fiuba-labo-de-micro-miercoles/2019-1c-trabajo-practico-inclinador-de-vaso/doc/otros/proceso_1.jpeg

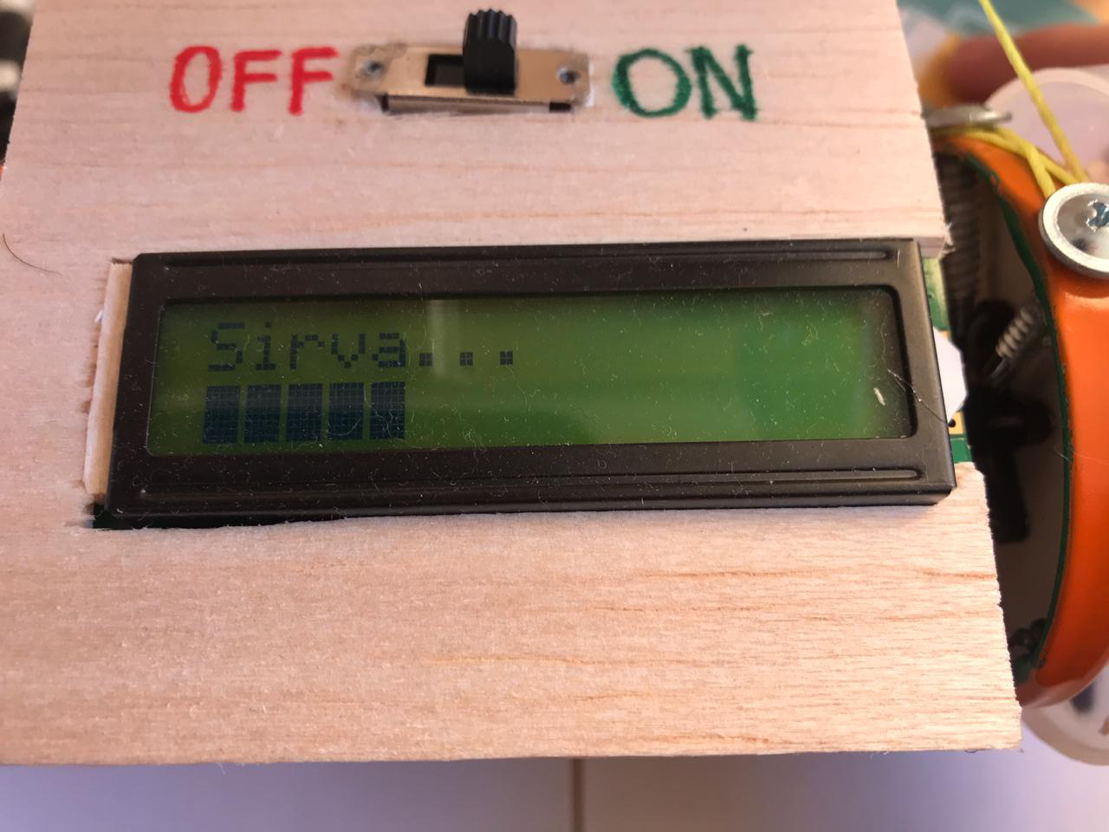
doc/otros/proceso_1.jpeg
