fiuba-labo-de-micro-miercoles/2019-1c-trabajo-practico-inclinador-de-vaso/README.md

Repositorio para la documentación de proyectos de
6609/8607 Laboratorio de Microcontroladores

Integrantes: 

            Quattrone martin 
            
            Segura Lola 
            
Proyecto:

                                                       S.H.I.V.A. 

Sistema Hibrido Inclinador de Vaso Automatizado

   El proyecto consta de lograr automatizar la inclinacion de un vaso de cerveza
a medida que es servida, para evitar la formacion de espuma excesiva en esta.

   Para ello se utilizara como parametro el peso del lıquido, a partir del cual el dispositivo tomara distintos
 ́angulos de inclinacion.
 
   El proyecto esta pensado para que el usuario sirva de manera manual la cerveza, por lo que se decidio incluir
en la base una pantalla led que vaya guiando el proceso.
