fiuba-labo-de-micro-miercoles/2019-1c-trabajo-practico-inclinador-de-vaso/doc/otros/leeme.txt

LINKS DE UTILIDAD

PARA LA PANTALLA LCD:
https://www.geekfactory.mx/tutoriales/tutoriales-arduino/pantalla-lcd-16x2-con-arduino/
https://www.arduino.cc/en/Reference/LiquidCrystal
