fiuba-labo-de-micro-miercoles/2019-1c-trabajo-practico-inclinador-de-vaso/doc/reportes/leeme.txt

Aquí se ubican los reportes y mediciones realizados durante el proyecto
