fiuba-labo-de-micro-miercoles/2019-1c-trabajo-practico-inclinador-de-vaso/doc/diagramas/Diagrama_de_Bloque.jpg

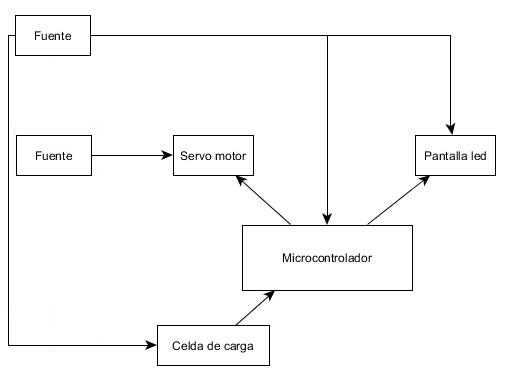
doc/diagramas/Diagrama_de_Bloque.jpg
