fiuba-labo-de-micro-miercoles/2019-1c-trabajo-practico-inclinador-de-vaso/doc/otros/Conexiones_2.jpeg

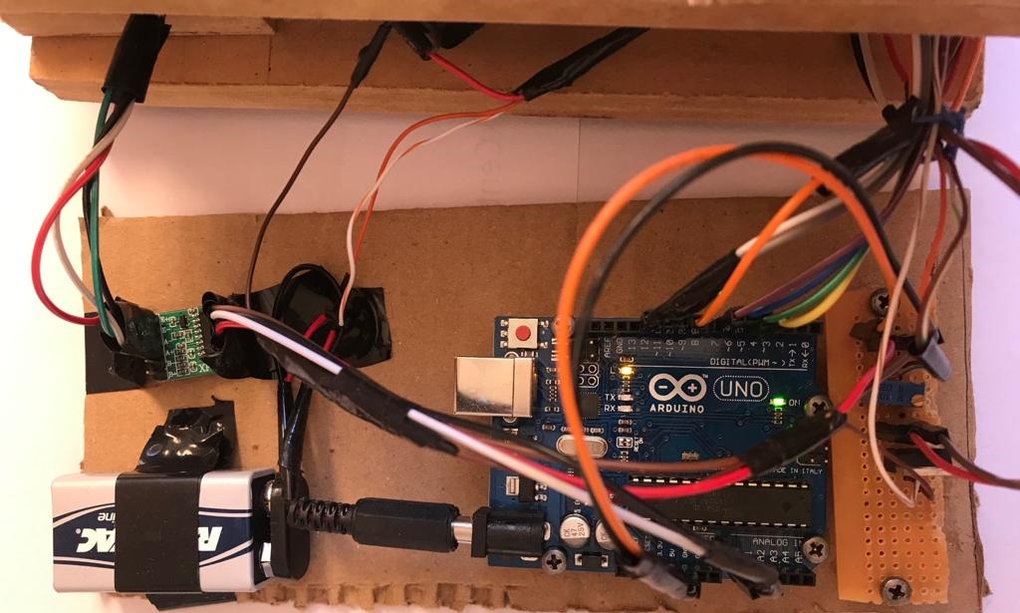
doc/otros/Conexiones_2.jpeg
