fiuba-labo-de-micro-miercoles/2019-1c-trabajo-practico-inclinador-de-vaso/doc/otros/inicio.jpeg

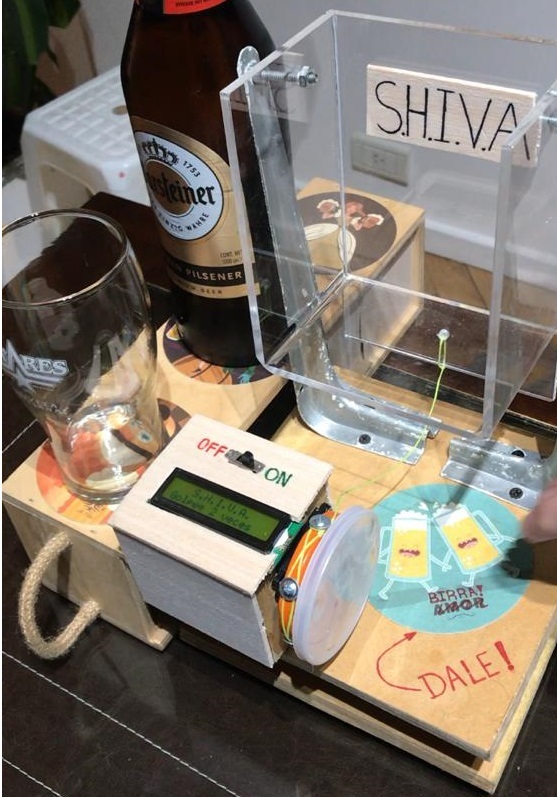
doc/otros/inicio.jpeg
