fiuba-labo-de-micro-miercoles/2019-1c-trabajo-practico-inclinador-de-vaso/doc/otros/sirviendo_4.jpeg

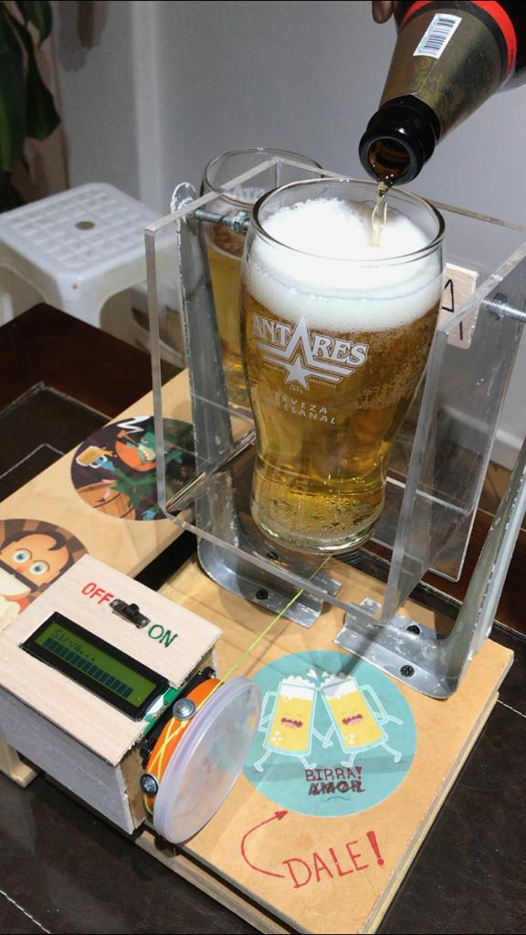
doc/otros/sirviendo_4.jpeg
