fiuba-labo-de-micro-miercoles/2019-1c-trabajo-practico-inclinador-de-vaso/Esquematico_shiva_esquemático.pdf

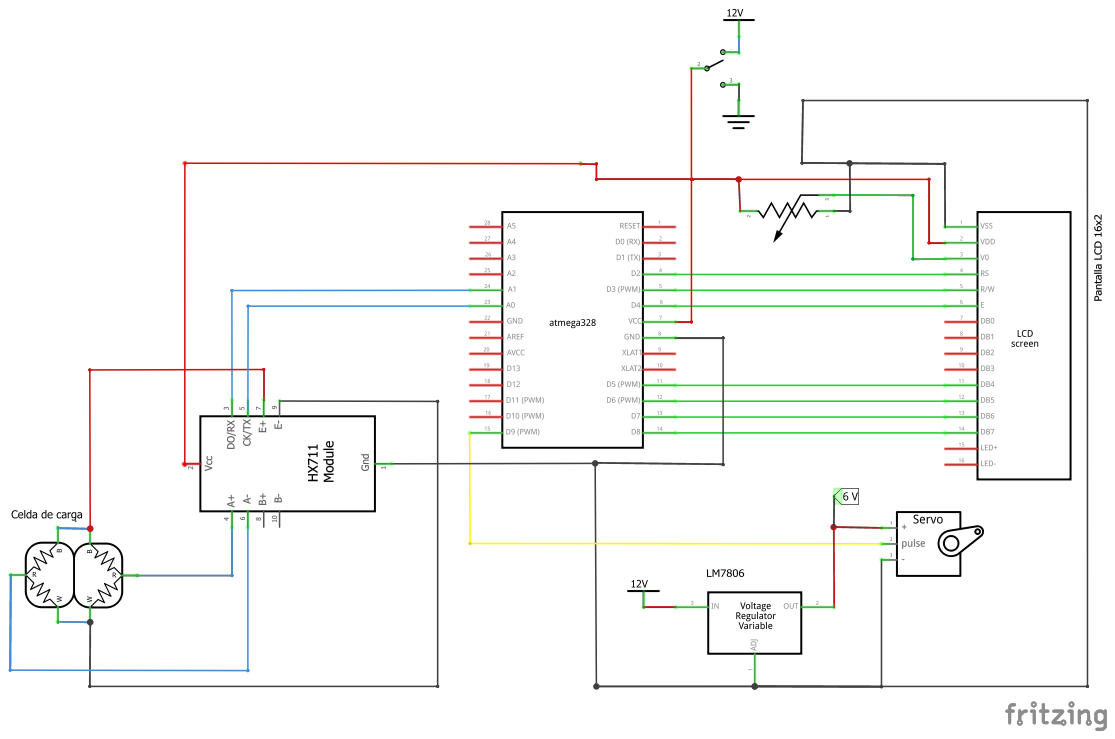
[picture p12: page 1]
