fiuba-labo-de-micro-miercoles/2019-1c-trabajo-practico-inclinador-de-vaso/esquematico/Esquematico_shiva_esquemático.pdf

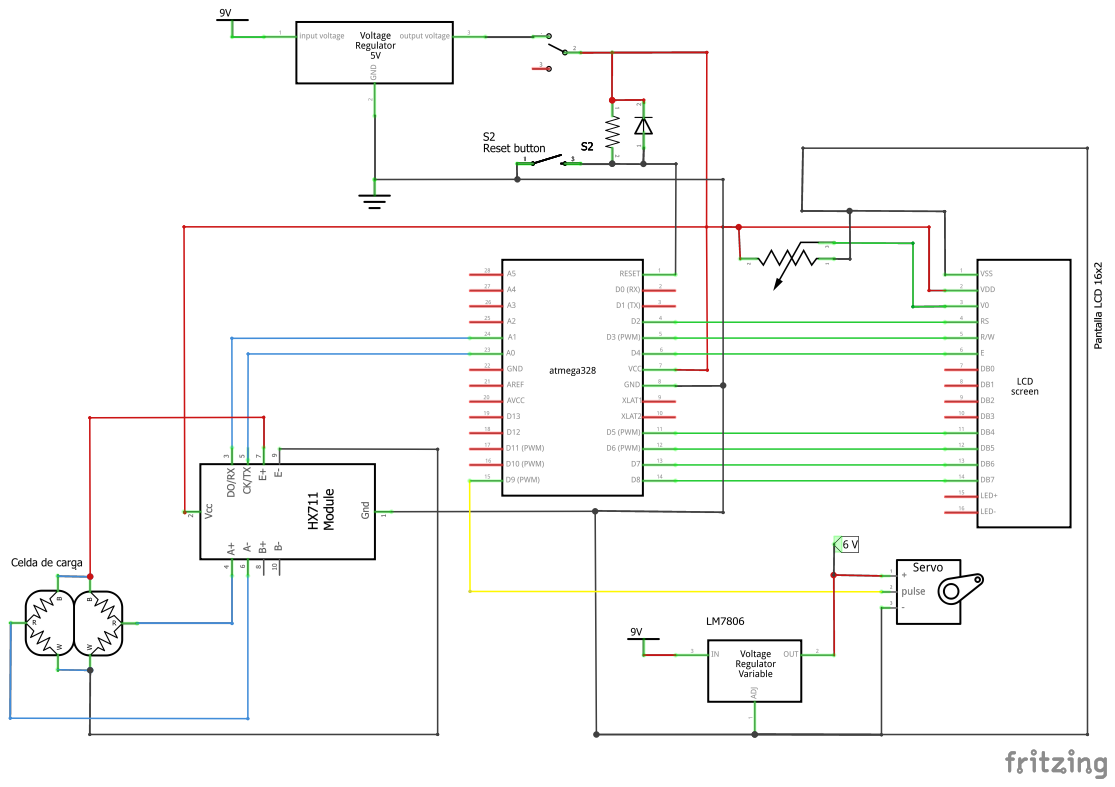
[picture p13: page 1]
