fiuba-labo-de-micro-miercoles/2019-1c-trabajo-practico-inclinador-de-vaso/(commit log)

2016-08-16 Se movió el contenido de leeme.txt a README.md
2016-08-16 Contenido movido a README.md, se borra el archivo
2016-08-16 Se movió la carpeta reportes al directorio de documentación
2019-06-01 Add files via upload
    Código de configuración balanza en C
